sergesyrota/GarageSensors/eagle/controller-v2.brd

## EAGLE design eagle/controller-v2.brd (2016-12-03)

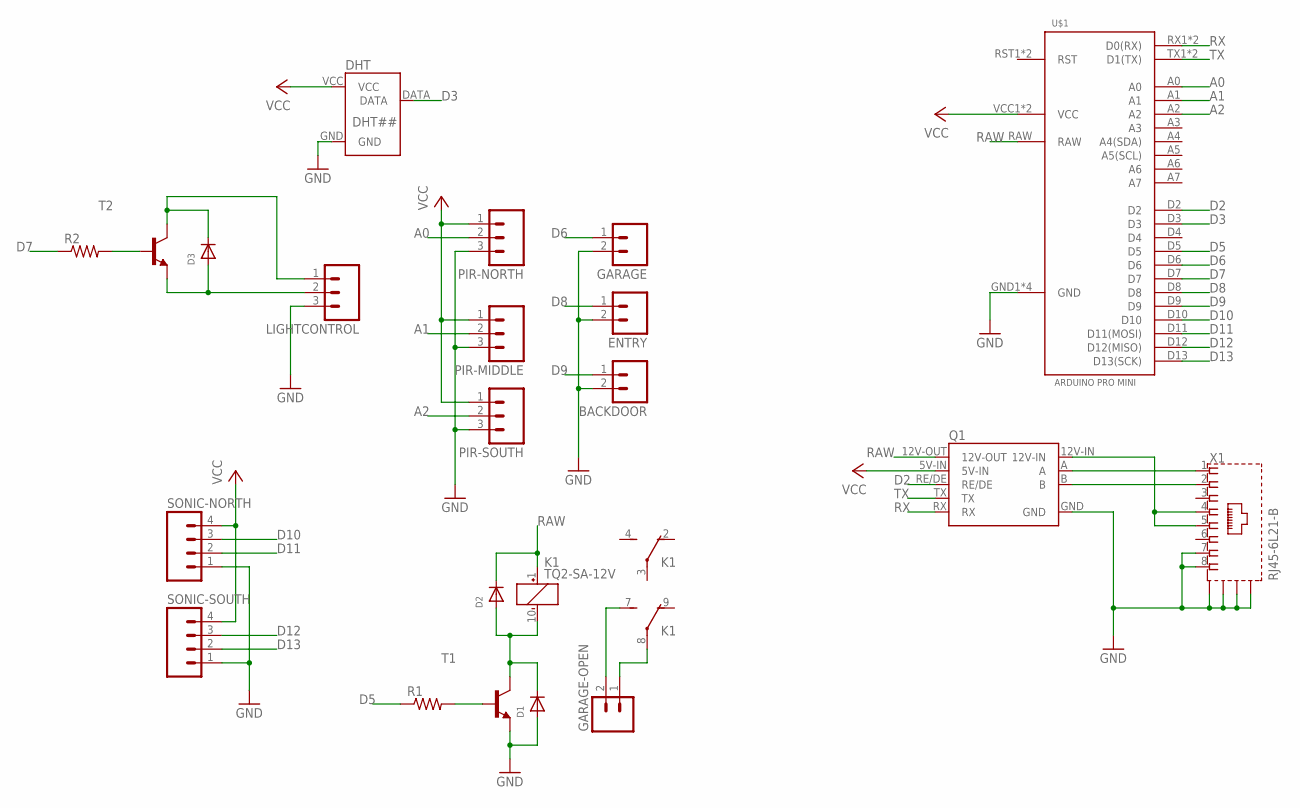
[picture p1: schematic controller-v2.sch]

Parts:
BACKDOOR: M02; 02P
D1, D2, D3: DIODESMA; SMADIODE
DHT: DHT##; CONNECTOR-4-PIN-0.1
ENTRY: M02; 02P
GARAGE: M02; 02P
GARAGE-OPEN: M02; 02P
K1: TQ2-SA-12V; TQ-SA
LIGHTCONTROL: M03; 03P
PIR-MIDDLE: M03; 03P
PIR-NORTH: M03; 03P
PIR-SOUTH: M03; 03P
Q1: RS485-ADAPTER0.05-CONNECTOR; RS485-ADAPTOR-05
R1, R2: R-US_R0603; R0603
SONIC-NORTH: M04; 04P
SONIC-SOUTH: M04; 04P
T1, T2: BC808-NPN-SOT23-BEC; SOT23-BEC
U$1: ARDUINO-PRO-MINI
X1: RJ45-6L21-B; RJ45-SHIELD1

Connections:
A0: PIR-NORTH.2, U$1.A0
A1: PIR-MIDDLE.2, U$1.A1
A2: PIR-SOUTH.2, U$1.A2
D2: Q1.RE/DE, U$1.D2
D3: DHT.DATA, U$1.D3
D5: R1.1, U$1.D5
D6: GARAGE.1, U$1.D6
D7: R2.1, U$1.D7
D8: ENTRY.1, U$1.D8
D9: BACKDOOR.1, U$1.D9
D10: SONIC-NORTH.3, U$1.D10
D11: SONIC-NORTH.2, U$1.D11 (D11(MOSI))
D12: SONIC-SOUTH.3, U$1.D12 (D12(MISO))
D13: SONIC-SOUTH.2, U$1.D13 (D13(SCK))
GND: BACKDOOR.2, D1.A, DHT.GND, ENTRY.2, GARAGE.2, LIGHTCONTROL.3, PIR-MIDDLE.3, PIR-NORTH.3, PIR-SOUTH.3, Q1.GND, SONIC-NORTH.1, SONIC-SOUTH.1, T1.E, U$1.GND1 (GND), U$1.GND2 (GND), U$1.GND3 (GND), U$1.GND4 (GND), X1.7, X1.8, X1.S1 (S), X1.S2 (S), X1.S3 (S), X1.S4 (S)
unnamed: D3.A, LIGHTCONTROL.2, T2.E
unnamed: Q1.12V-IN, X1.4, X1.5
unnamed: GARAGE-OPEN.1, K1.8
unnamed: Q1.A, X1.1
unnamed: Q1.B, X1.2
unnamed: GARAGE-OPEN.2, K1.7 (S)
unnamed: D1.C, D2.A, K1.10 (-), T1.C
unnamed: R1.2, T1.B
unnamed: D3.C, LIGHTCONTROL.1, T2.C
unnamed: R2.2, T2.B
RAW: D2.C, K1.1 (+), Q1.12V-OUT, U$1.RAW
RX: Q1.RX, U$1.RX1 (D0(RX)), U$1.RX2 (D0(RX))
TX: Q1.TX, U$1.TX1 (D1(TX)), U$1.TX2 (D1(TX))
VCC: DHT.VCC, PIR-MIDDLE.1, PIR-NORTH.1, PIR-SOUTH.1, Q1.5V-IN, SONIC-NORTH.4, SONIC-SOUTH.4, U$1.VCC1 (VCC), U$1.VCC2 (VCC)

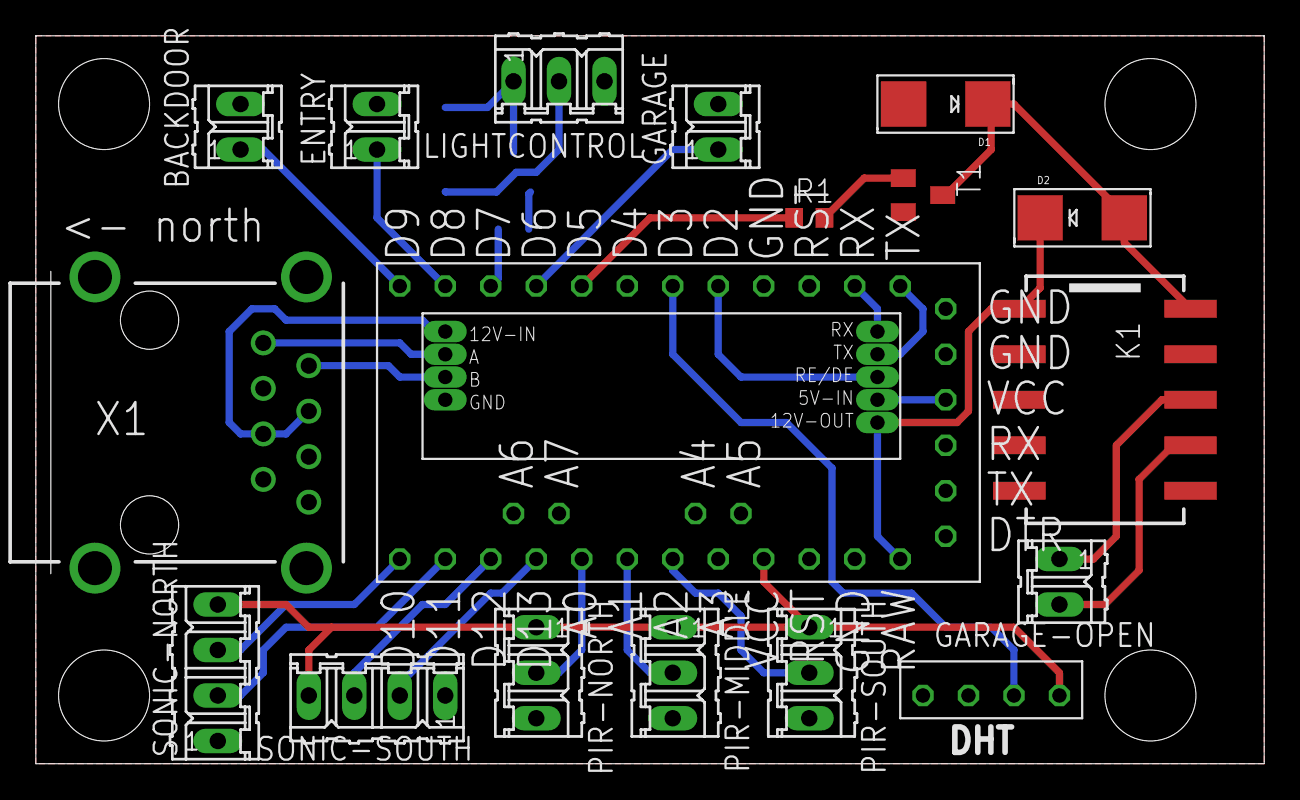
[picture p2: board controller-v2.brd from above]

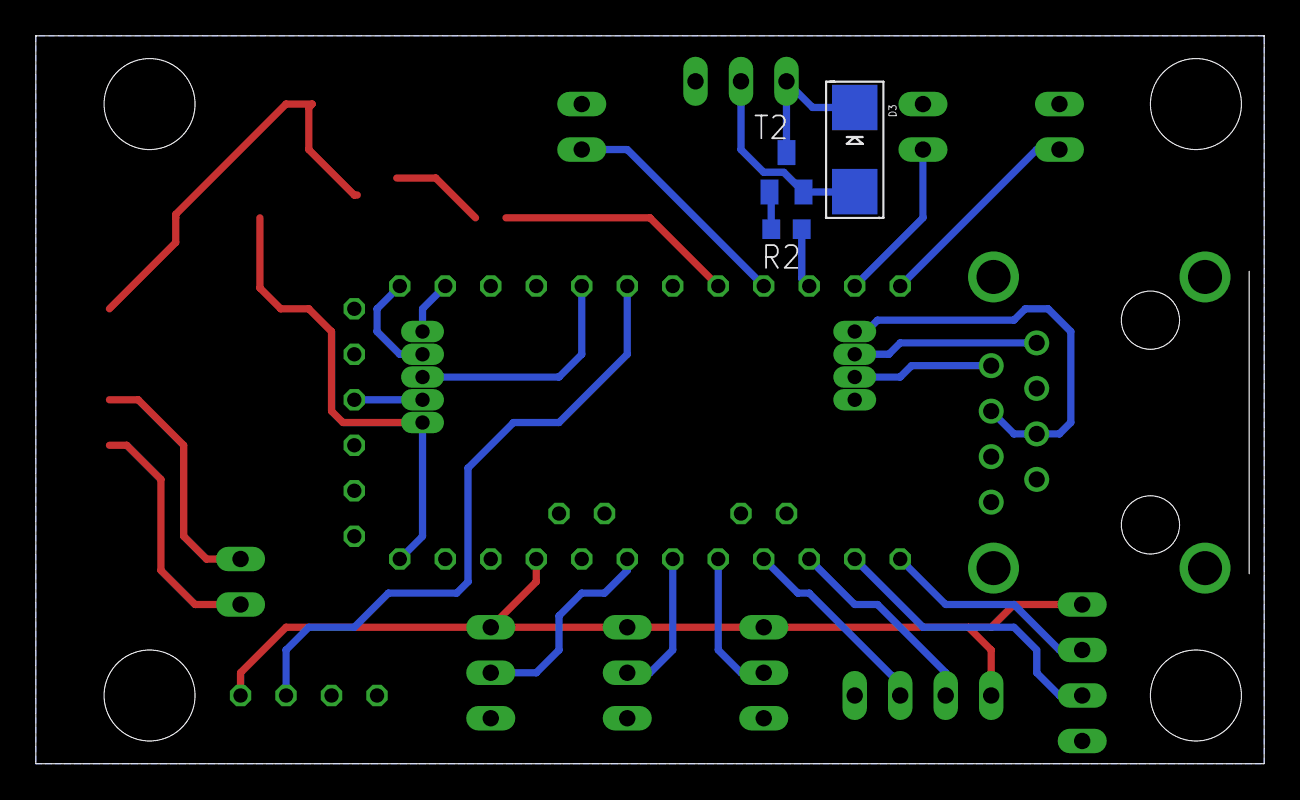
[picture p3: board controller-v2.brd from below]

Board: 2 copper layers, 68.6 x 40.6 mm, 22 parts (3 on the bottom side), 29 nets.
