sergesyrota/GarageSensors/(commit log)

2016-12-03 Finalized garage sensors project, and installed.
    [controller-v1.brd, controller-v1.sch, controller-v2 - leanbpc.brd, controller-v2.brd, controller-v2.sch, cpu-mount.scad]
2016-12-04 Fixed inverted door open/close check; Fixed setting motion lights timeout with int vs long conversion
    [Arduino.ino]
